opilitethesmartdev/opi-siliconpudx-pcb/opi-siliconpudx.kicad_pcb

## KiCad design opi-siliconpudx.kicad_pcb (2026-11-09)

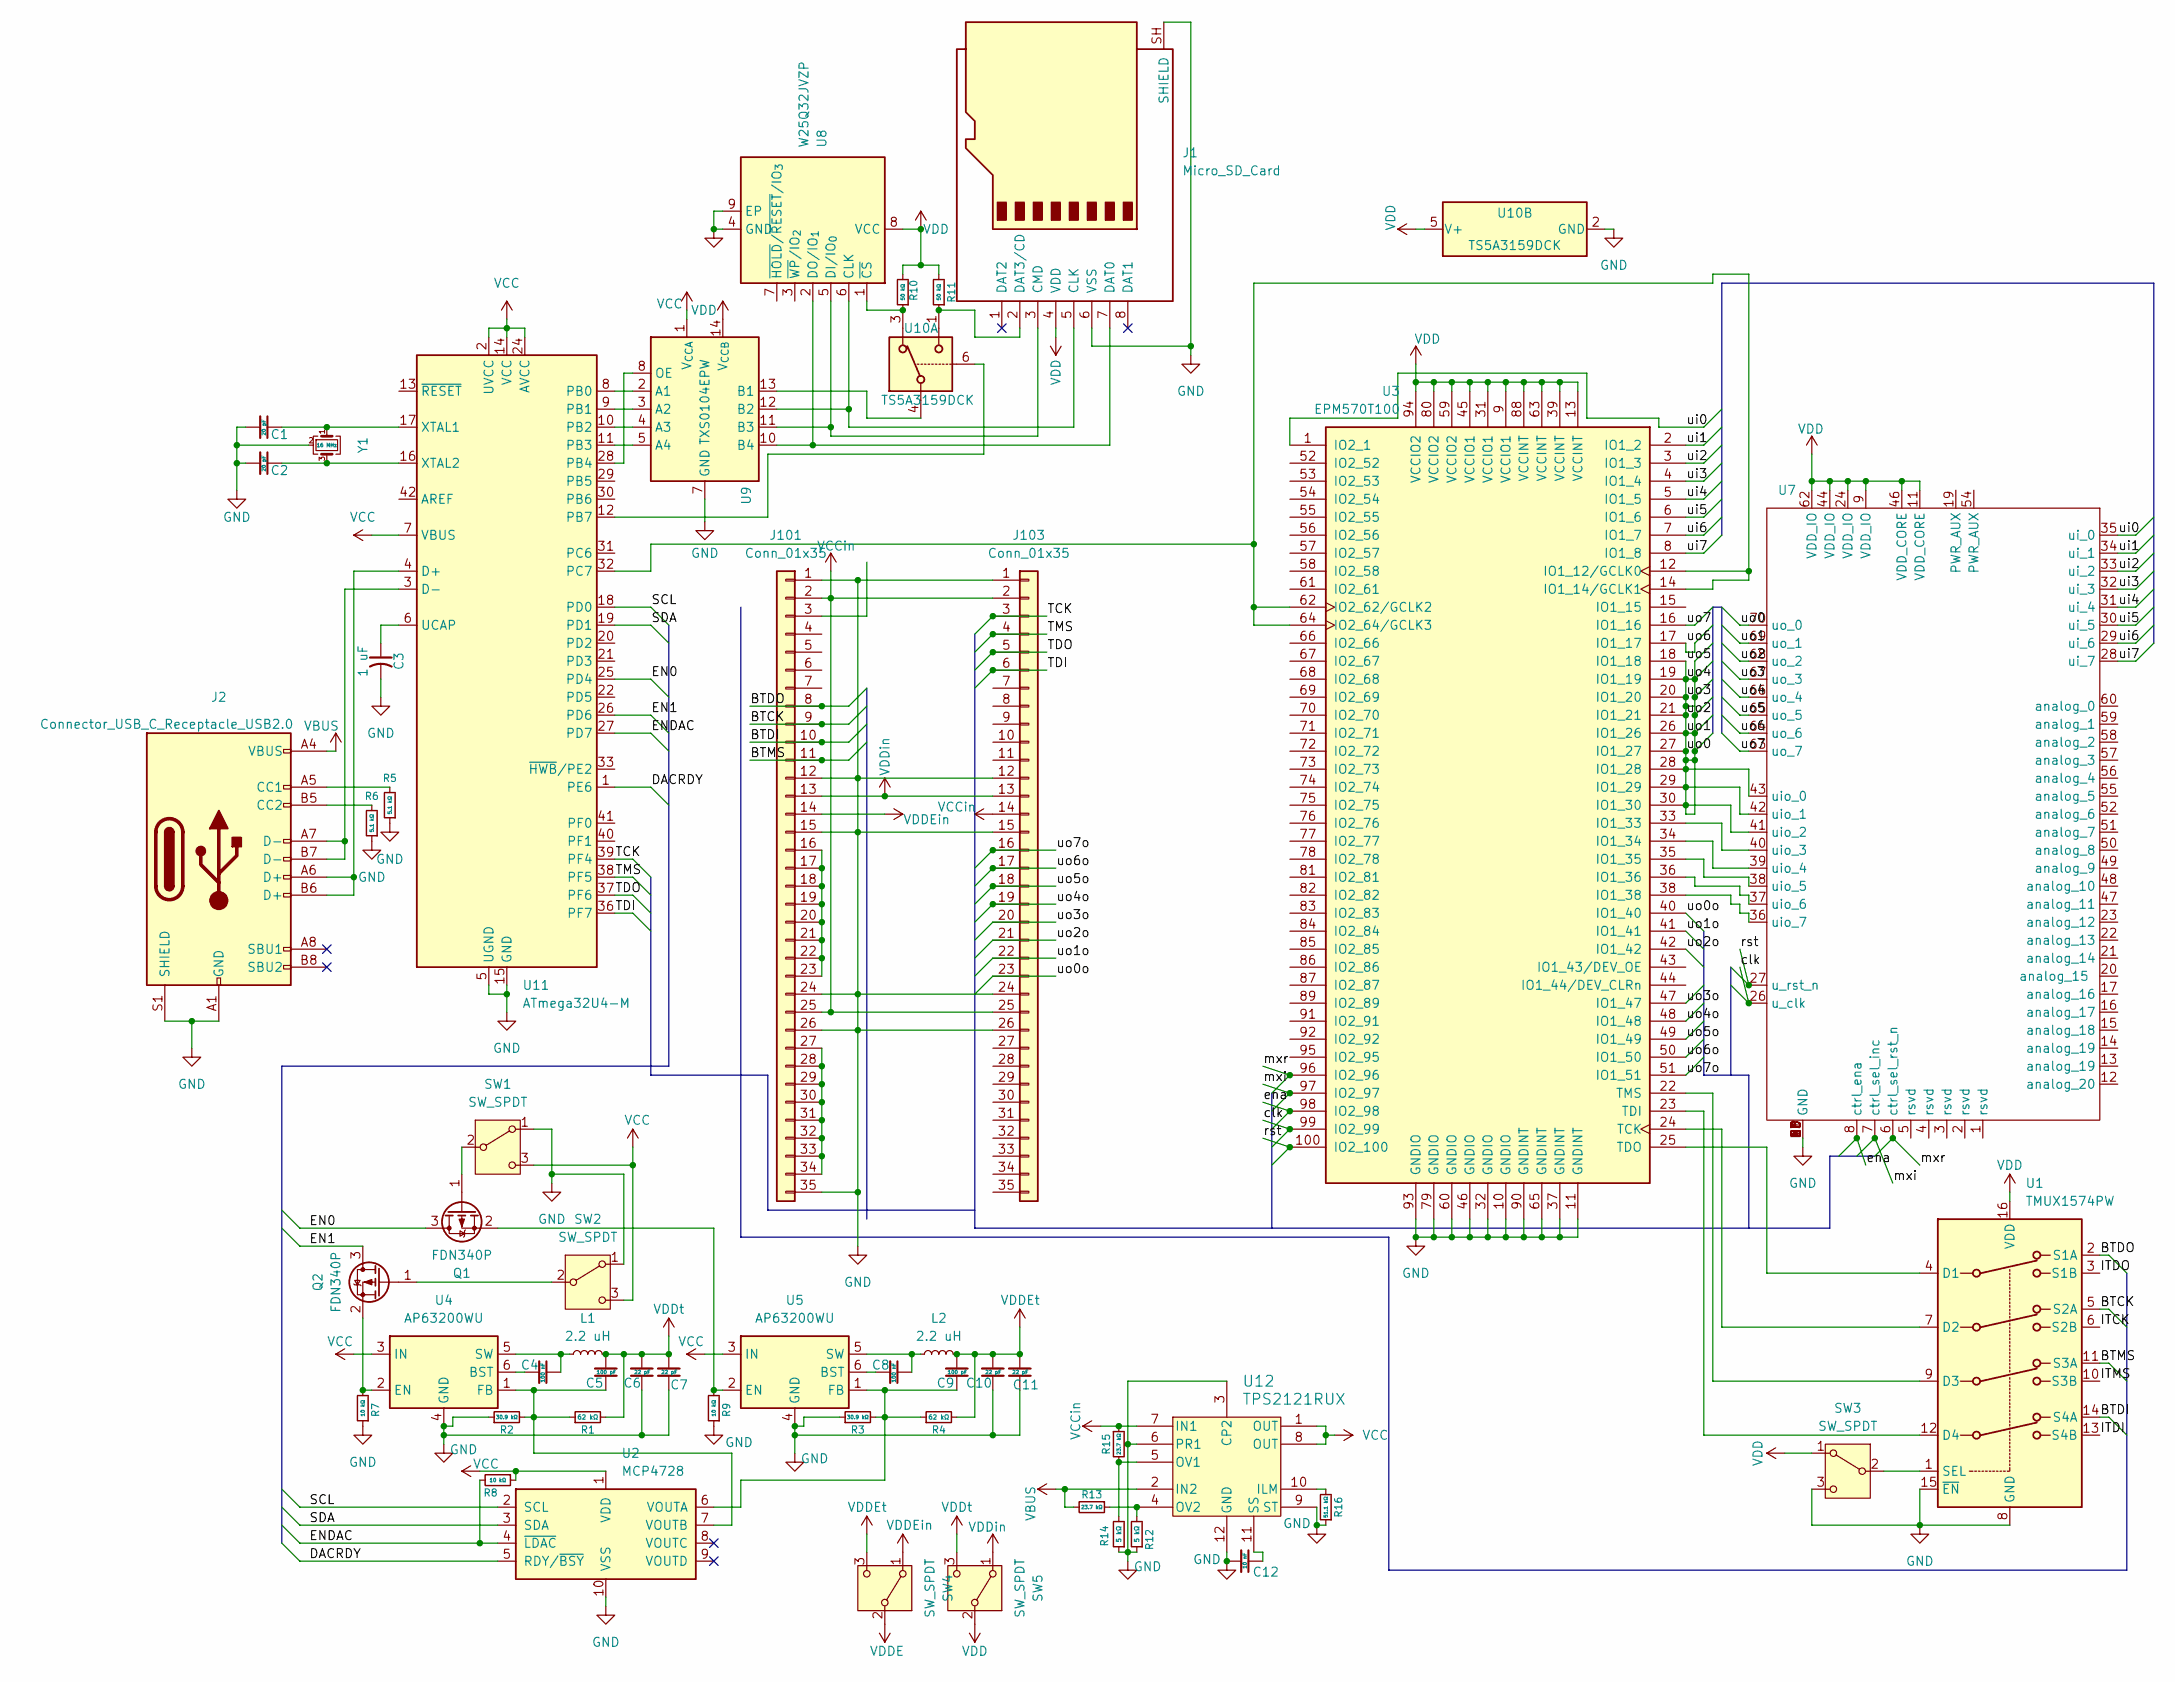
[picture p1: schematic opi-siliconpudx.kicad_sch]

Parts:
C1, C2: 20 pF; C_01005_0402Metric
C3: 1 uF; C_0201_0603Metric
C4, C8: 100 nF; C_01005_0402Metric
C5, C9: 100 pF; C_01005_0402Metric
C6, C7, C10, C11: 22 pF; C_01005_0402Metric
C12: 10 nF; C_01005_0402Metric
J1: Micro_SD_Card; microSD_HC_Molex_47219-2001
J2: Connector_USB_C_Receptacle_USB2.0; TYPE-C-31-M-14
J101, J103: Conn_01x35; PinHeader_1x35_P2.54mm_Vertical
L1, L2: 2.2 uH; L_Cenker_CKCS201610
Q1, Q2: FDN340P; SOT-23
R1, R4: 62 kΩ; R_01005_0402Metric
R2, R3: 30.9 kΩ; R_01005_0402Metric
R5, R6: 5.1 kΩ; R_01005_0402Metric
R7, R8, R9: 10 kΩ; R_01005_0402Metric
R10, R11: 50 kΩ; R_01005_0402Metric
R12, R14: 5 kΩ; R_01005_0402Metric
R13, R15: 23.7 kΩ; R_01005_0402Metric
R16: 51.1 kΩ; R_01005_0402Metric
SW1, SW2, SW3, SW4, SW5: SW_SPDT; PinHeader_1x03_P2.00mm_Vertical
U1: TMUX1574PW; TSSOP-16_4.4x5mm_P0.65mm
U2: MCP4728; MSOP-10_3x3mm_P0.5mm
U3: EPM570T100; LQFP-100_14x14mm_P0.5mm
U4, U5: AP63200WU; TSOT-23-6
U7: CONN-SMD_70P-P0.40_HCTL_HC-PBB40C-70DP-0.4V-02
U8: W25Q32JVZP; WSON-8-1EP_6x5mm_P1.27mm_EP3.4x4.3mm
U9: TXS0104EPW; TSSOP-14_4.4x5mm_P0.65mm
U10: TS5A3159DCK; SOT-363_SC-70-6
U11: ATmega32U4-M; QFN-44-1EP_7x7mm_P0.5mm_EP5.2x5.2mm
U12: TPS2121RUX; RUX0012A
Y1: 16 MHz; Crystal_SMD_2016-4Pin_2.0x1.6mm

Connections:
/BTCK: J101.9, U1.5 (S2A)
/BTDI: J101.10, U1.14 (S4A)
/BTDO: J101.8, U1.2 (S1A)
/BTMS: J101.11, U1.11 (S3A)
/DACRDY: U2.5 (RDY/~BSY), U11.1 (PE6)
/EN0: Q1.3 (D), U11.25 (PD4)
/EN1: Q2.3 (D), U11.26 (PD6)
/ENDAC: R8.2, U2.4 (~LDAC), U11.27 (PD7)
/ITCK: U1.6 (S2B)
/ITDI: U1.13 (S4B)
/ITDO: U1.3 (S1B)
/ITMS: U1.10 (S3B)
/SCL: U2.2 (SCL), U11.18 (PD0)
/SDA: U2.3 (SDA), U11.19 (PD1)
/TCK: J103.3, U11.39 (PF4)
/TDI: J103.6, U11.36 (PF7)
/TDO: J103.5, U11.37 (PF6)
/TMS: J103.4, U11.38 (PF5)
/clk: U3.99 (IO2_99), U7.26 (u_clk)
/ena: U3.98 (IO2_98), U7.8 (ctrl_ena)
/mxi: U3.97 (IO2_97), U7.7 (ctrl_sel_inc)
/mxr: U3.96 (IO2_96), U7.6 (ctrl_sel_rst_n)
/rst: U3.100 (IO2_100), U7.27 (u_rst_n)
/ui0: U3.1 (IO2_1), U7.35 (ui_0)
/ui1: U3.2 (IO1_2), U7.34 (ui_1)
/ui2: U3.3 (IO1_3), U7.33 (ui_2)
/ui3: U3.4 (IO1_4), U7.32 (ui_3)
/ui4: U3.5 (IO1_5), U7.31 (ui_4)
/ui5: U3.6 (IO1_6), U7.30 (ui_5)
/ui6: U3.7 (IO1_7), U7.29 (ui_6)
/ui7: U3.8 (IO1_8), U7.28 (ui_7)
/uo0: U3.18 (IO1_18), U3.19 (IO1_19), U3.20 (IO1_20), U3.21 (IO1_21), U3.26 (IO1_26), U3.27 (IO1_27), U3.28 (IO1_28), U3.29 (IO1_29), U3.30 (IO1_30), U7.41 (uio_2), U7.42 (uio_1), U7.43 (uio_0), U7.65 (uo_5), U7.66 (uo_4), U7.67 (uo_3), U7.68 (uo_2), U7.69 (uo_1), U7.70 (uo_0)
/uo0o: J103.23, U3.40 (IO1_40)
/uo1o: J103.22, U3.41 (IO1_41)
/uo2o: J103.21, U3.42 (IO1_42)
/uo3o: J103.20, U3.47 (IO1_47)
/uo4o: J103.19, U3.48 (IO1_48)
/uo5o: J103.18, U3.49 (IO1_49)
/uo6: U3.17 (IO1_17), U7.64 (uo_6)
/uo6o: J103.17, U3.50 (IO1_50)
/uo7: U3.16 (IO1_16), U7.63 (uo_7)
/uo7o: J103.16, U3.51 (IO1_51)
GND: C1.1, C2.1, C3.2, C6.1, C7.1, C10.1, C11.1, C12.2, J1.6 (VSS), J1.SH (SHIELD), J2.A1 (GND), J2.A12 (GND), J2.B1 (GND), J2.B12 (GND), J2.S1 (SHIELD), J101.1, J101.12, J101.15, J101.24, J101.26, J101.35, J103.1, J103.12, J103.15, J103.24, J103.26, R2.1, R3.1, R5.1, R6.1, R7.1, R9.1, R12.1, R14.1, R16.1, SW1.1 (A), SW2.1 (A), SW3.3 (C), U1.8 (GND), U1.15 (~EN), U2.10 (VSS), U3.10 (GNDIO), U3.11 (GNDINT), U3.32 (GNDIO), U3.37 (GNDINT), U3.46 (GNDIO), U3.60 (GNDIO), U3.65 (GNDINT), U3.79 (GNDIO), U3.90 (GNDINT), U3.93 (GNDIO), U4.4 (GND), U5.4 (GND), U7.10 (GND), U7.18 (GND), U7.25 (GND), U7.45 (GND), U7.53 (GND), U7.61 (GND), U7.MP (GND), U8.4 (GND), U8.9 (EP), U9.7 (GND), U10.2 (GND), U11.5 (UGND), U11.15 (GND), U11.23 (GND), U11.35 (GND), U11.43 (GND), U11.45 (GND), U12.3 (CP2), U12.6 (PR1), U12.9 (ST), U12.12 (GND), Y1.2 (G), Y1.4 (G)
unnamed: J1.5 (CLK), U8.6 (CLK), U9.12 (B2)
unnamed: J1.3 (CMD), U8.5 (DI/IO_{0}), U9.11 (B3)
unnamed: J1.7 (DAT0), U8.2 (DO/IO_{1}), U9.10 (B4)
unnamed: J1.2 (DAT3/CD), R11.1, U10.1
unnamed: J2.A5 (CC1), R5.2
unnamed: J2.B5 (CC2), R6.2
unnamed: J101.16, J101.17, J101.18, J101.19, J101.20, J101.21, J101.22, J101.23
unnamed: J101.27, J101.28, J101.29, J101.30, J101.31, J101.32, J101.33, J101.34
unnamed: Q1.1 (G), SW1.2 (B)
unnamed: Q1.2 (S), R9.2, U5.2 (EN)
unnamed: Q2.1 (G), SW2.2 (B)
unnamed: Q2.2 (S), R7.2, U4.2 (EN)
unnamed: SW3.2 (B), U1.1 (SEL)
unnamed: U1.4 (D1), U3.25 (TDO)
unnamed: U1.7 (D2), U3.24 (TCK)
unnamed: U1.9 (D3), U3.22 (TMS)
unnamed: U1.12 (D4), U3.23 (TDI)
unnamed: C9.1, R3.2, R4.1, U2.6 (VOUTA), U5.1 (FB)
unnamed: C5.1, R1.1, R2.2, U2.7 (VOUTB), U4.1 (FB)
unnamed: U3.33 (IO1_33), U7.40 (uio_3)
unnamed: U3.34 (IO1_34), U7.39 (uio_4)
unnamed: U3.35 (IO1_35), U7.38 (uio_5)
unnamed: U3.36 (IO1_36), U7.37 (uio_6)
unnamed: U3.38 (IO1_38), U7.36 (uio_7)
unnamed: C4.1, U4.6 (BST)
unnamed: C4.2, L1.1, U4.5 (SW)
unnamed: C8.1, U5.6 (BST)
unnamed: C8.2, L2.1, U5.5 (SW)
unnamed: R10.1, U8.1 (~CS), U10.3
unnamed: U9.13 (B1), U10.4
unnamed: J2.A6 (D+), J2.B6 (D+), U11.4 (D+)
unnamed: J2.A7 (D-), J2.B7 (D-), U11.3 (D-)
unnamed: U9.2 (A1), U11.8 (PB0)
unnamed: U9.3 (A2), U11.9 (PB1)
unnamed: U9.4 (A3), U11.10 (PB2)
unnamed: U9.5 (A4), U11.11 (PB3)
unnamed: U9.8 (OE), U11.28 (PB4)
unnamed: U10.6, U11.12 (PB7)
unnamed: U3.12 (IO1_12/GCLK0), U3.14 (IO1_14/GCLK1), U3.62 (IO2_62/GCLK2), U3.64 (IO2_64/GCLK3), U11.32 (PC7)
unnamed: C3.1, U11.6 (UCAP)
unnamed: C1.2, U11.17 (XTAL1), Y1.1
unnamed: C2.2, U11.16 (XTAL2), Y1.3
unnamed: R16.2, U12.10 (ILM)
unnamed: R14.2, R15.2, U12.5 (OV1)
unnamed: R12.2, R13.1, U12.4 (OV2)
unnamed: C12.1, U12.11 (SS)
VBUS: J2.A4 (VBUS), J2.A9 (VBUS), J2.B4 (VBUS), J2.B9 (VBUS), R13.2, U12.2 (IN2)
VCC: R8.1, SW1.3 (C), SW2.3 (C), U2.1 (VDD), U4.3 (IN), U5.3 (IN), U9.1 (V_{CCA}), U11.2 (UVCC), U11.7 (VBUS), U11.14 (VCC), U11.24 (AVCC), U11.34 (VCC), U11.44 (AVCC), U12.1 (OUT), U12.8 (OUT)
VCCin: J101.2, J101.25, J103.2, J103.14, J103.25, R15.1, U12.7 (IN1)
VDD: J1.4 (VDD), R10.2, R11.2, SW3.1 (A), SW5.2 (B), U1.16 (VDD), U3.9 (VCCIO1), U3.13 (VCCINT), U3.31 (VCCIO1), U3.39 (VCCINT), U3.45 (VCCIO1), U3.59 (VCCIO2), U3.63 (VCCINT), U3.80 (VCCIO2), U3.88 (VCCINT), U3.94 (VCCIO2), U7.9 (VDD_IO), U7.11 (VDD_CORE), U7.24 (VDD_IO), U7.44 (VDD_IO), U7.46 (VDD_CORE), U7.62 (VDD_IO), U8.8 (VCC), U9.14 (V_{CCB}), U10.5 (V+)
VDDE: SW4.2 (B)
VDDEin: J101.14, SW4.1 (A)
VDDEt: C9.2, C10.2, C11.2, L2.2, R4.2, SW4.3 (C)
VDDin: J101.13, J103.13, SW5.1 (A)
VDDt: C5.2, C6.2, C7.2, L1.2, R1.2, SW5.3 (C)

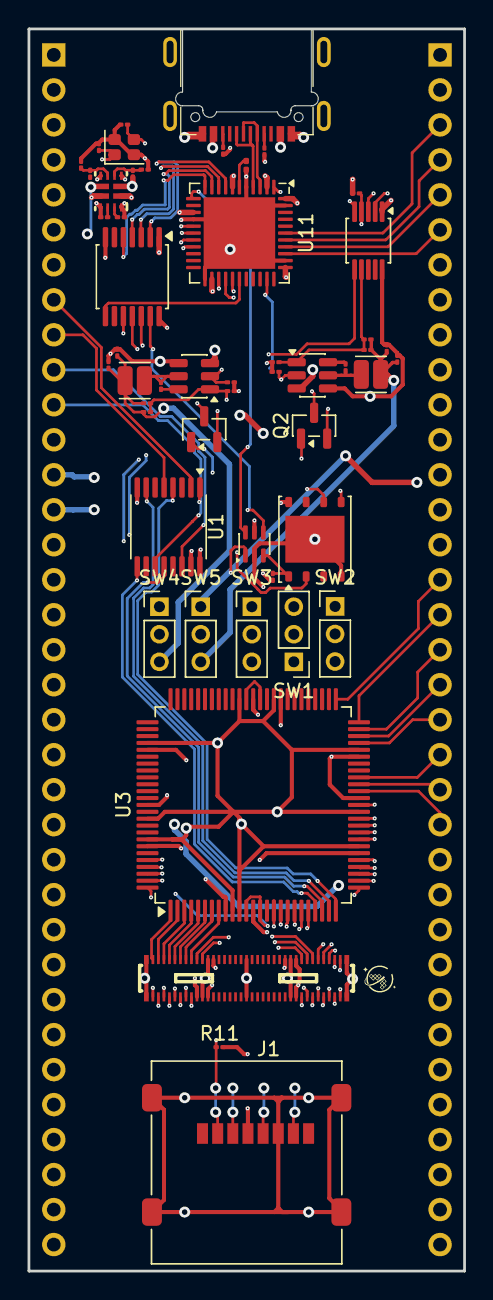
[picture p2: board opi-siliconpudx.kicad_pcb from above]

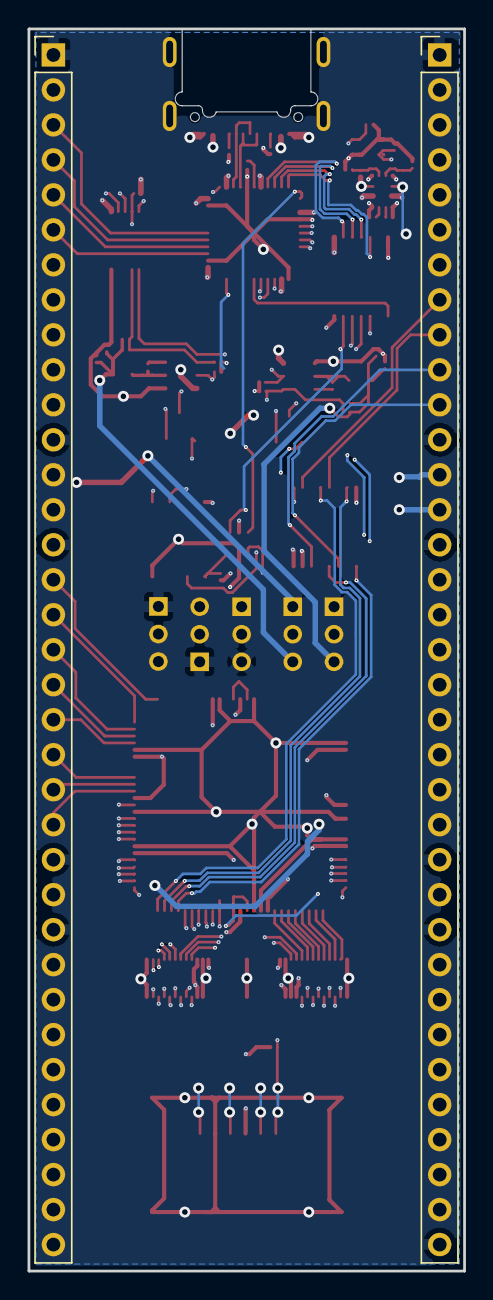
[picture p3: board opi-siliconpudx.kicad_pcb from below]

Board: 4 copper layers, 31.6 x 90.2 mm, 53 parts (2 on the bottom side), 93 nets.
